ozanakturk/Dragonfly/final report/figures/leakage.jpg

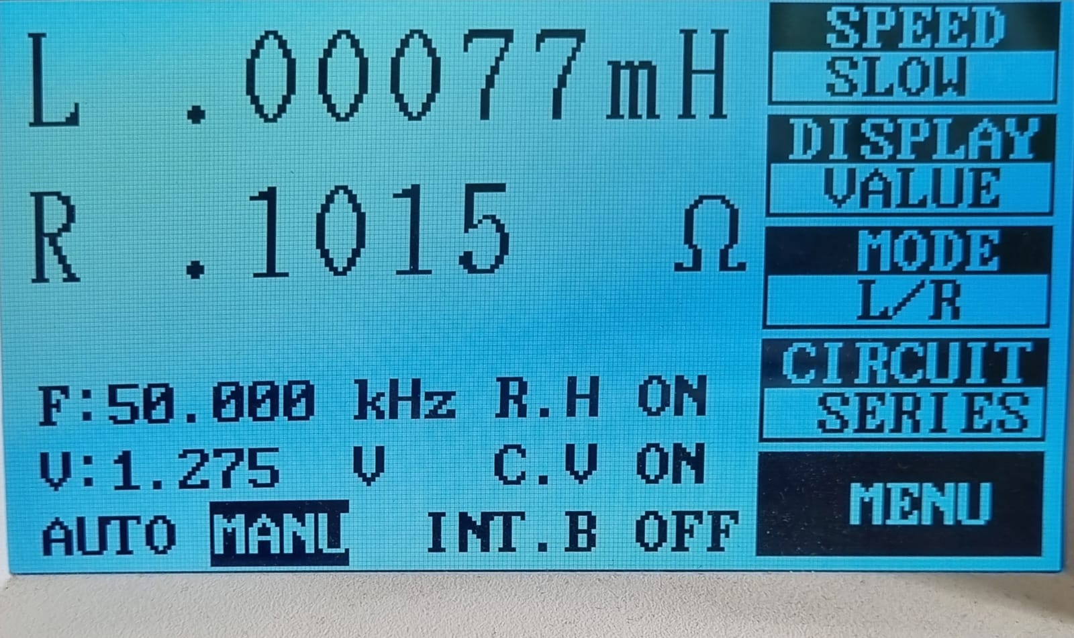
final report/figures/leakage.jpg
