ozanakturk/Dragonfly/final report/figures/trafo test.jpg

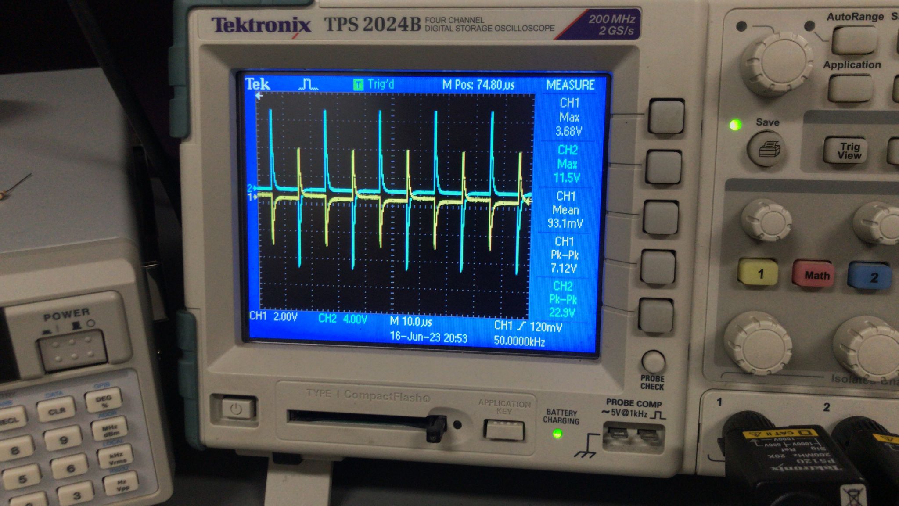
final report/figures/trafo test.jpg
