ozanakturk/Dragonfly/README.md

# DRAGONFLY - 2022/2023 EE464 Project Group
