ozanakturk/Dragonfly/presentation/EE464 Hardware Project Presentation.pptx

## EE464 Hardware Project Presentation


Group Name: Dragonfly

## Specifications

- Minimum Input Voltage: 12 V
- Maximum Input Voltage: 18 V
- Output Voltage: 48 V
- Output Power: 48 W
- Output Voltage Peak-to-Peak Ripple: 3%
- Line Regulation(Deviation of percent output voltage when input voltage is changed from its minimum to maximum or vice versa): 3%
- Load Regulation(Deviation of percent output voltage when load current is changed from 10% to 100% or vice versa): 3%

## Topology Selection: Flyback Converter

- Most common isolated converter
- Smaller number of components
- Low cost
- Less number of turn on the transformer
- Easy to control

## Theoretical Calculations

- N2/N1 = 3 & 0.47≤D≤0.58
- Lm = 59.68 uH
- Im_avg = 6.9A, Im_max = 8.3A
- Npri = 16
- MMF = 22.68 A-t
- Rpri = 107.8 / n_pri, Rsec = 323.4 / n_sec
- B_max = 0.12T, Pcore = 6.68W, Pcopper = 1.42W
- Efficiency = 85.56% (only core and copper losses are included)

## Simulation Results

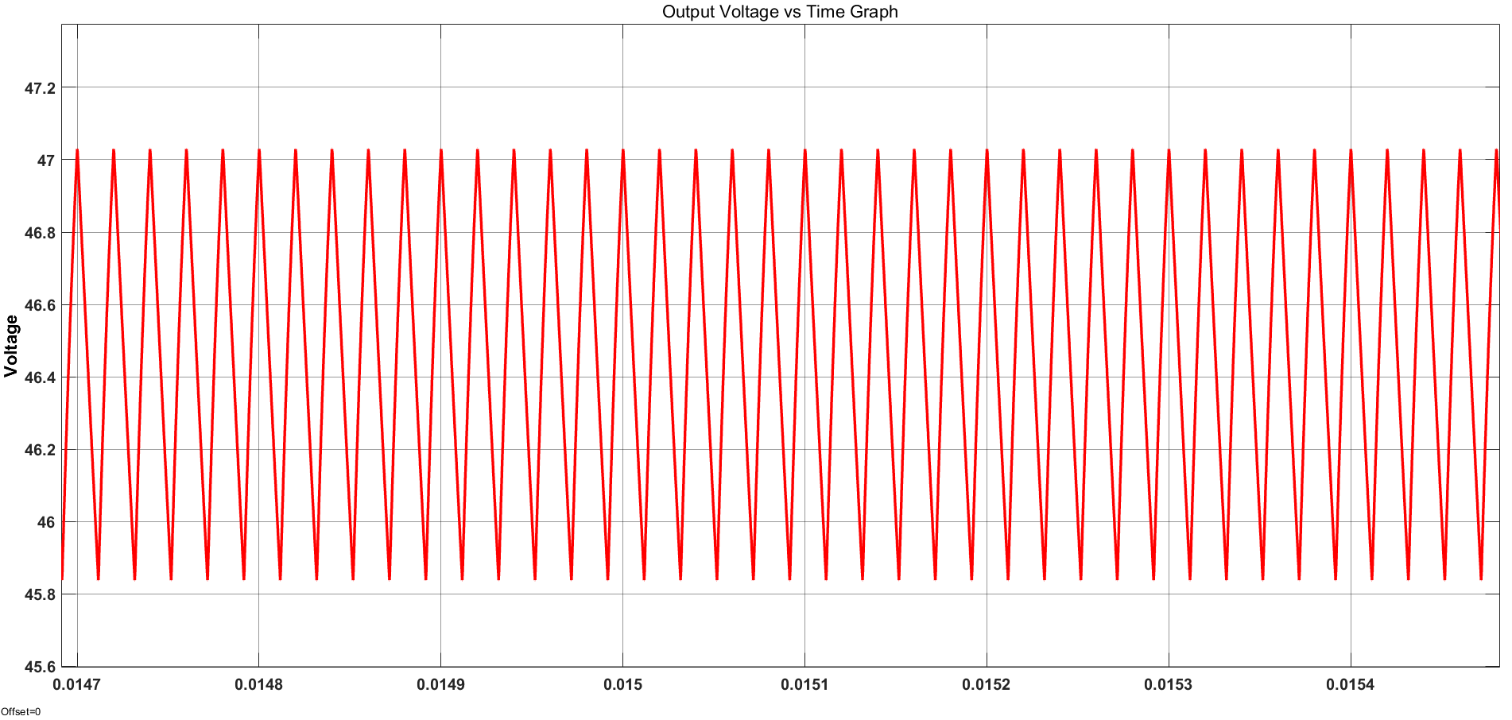
[picture p10: figure]
metin, ekran görüntüsü, çizgi, öykü gelişim çizgisi; kumpas; grafiğini çıkarma içeren bir resim Açıklama otomatik olarak oluşturuldu

(∆Vo)/(Vo)=1.19/46.46∗100=2.56%

## Slide 6

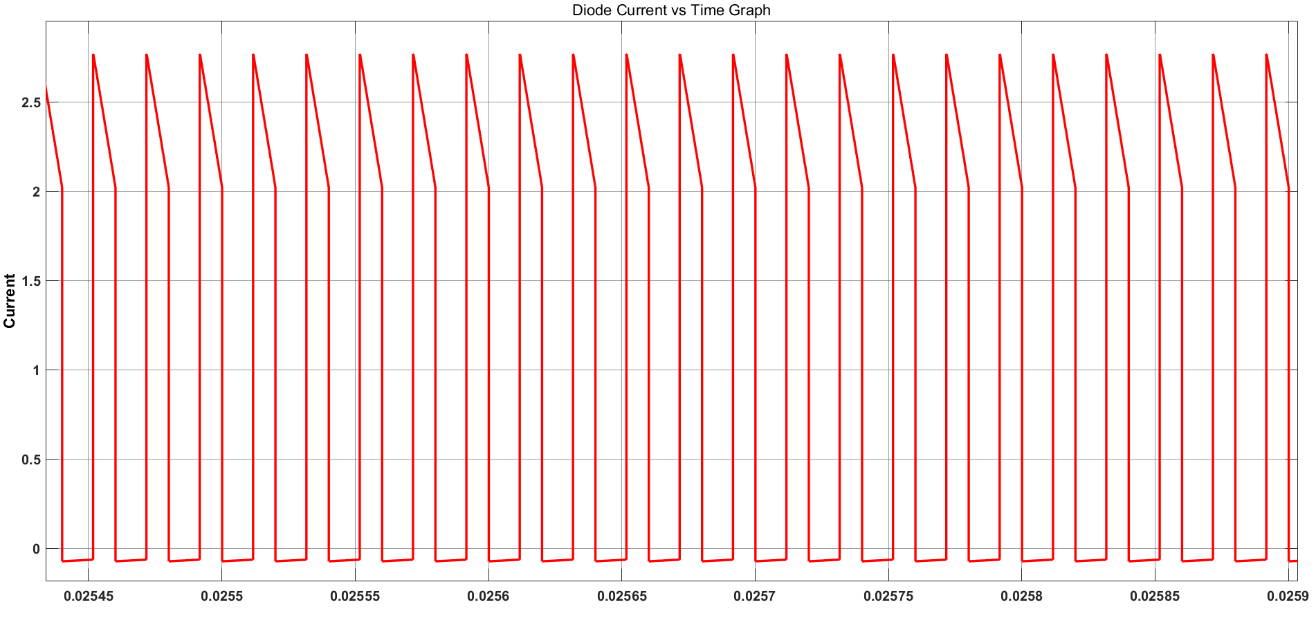
[picture p11: figure]
metin, çizgi, öykü gelişim çizgisi; kumpas; grafiğini çıkarma, ekran görüntüsü içeren bir resim Açıklama otomatik olarak oluşturuldu

Id_max = 2.77A
Pd_max = 1.07W

## Slide 7

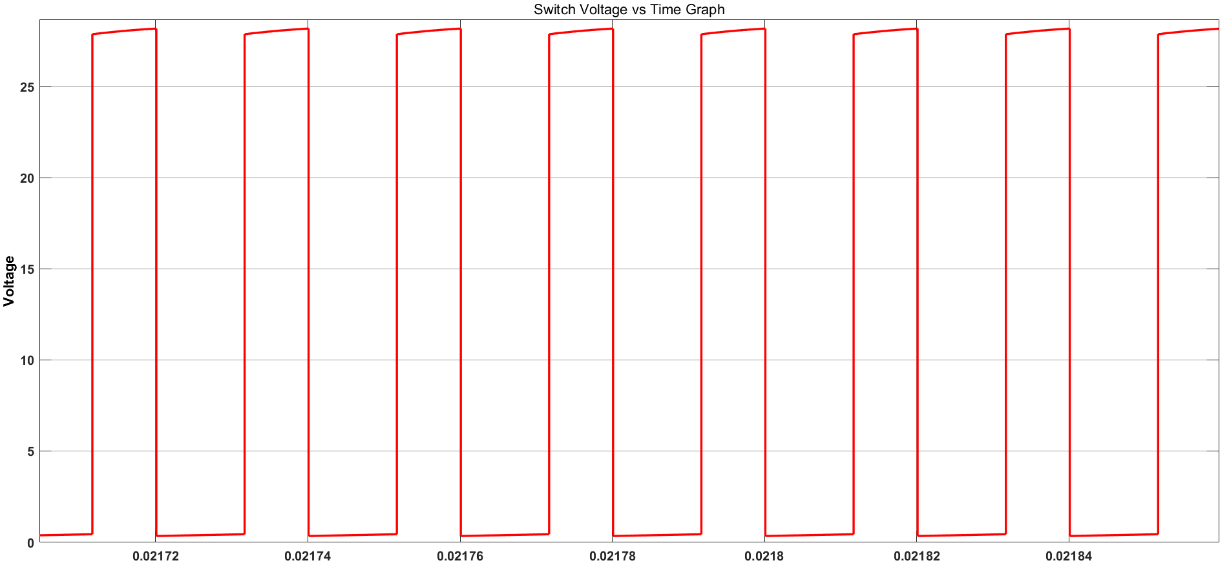
[picture p12: figure]
metin, çizgi, öykü gelişim çizgisi; kumpas; grafiğini çıkarma, diyagram içeren bir resim Açıklama otomatik olarak oluşturuldu

Vsw_max = 28.18V

## Slide 8

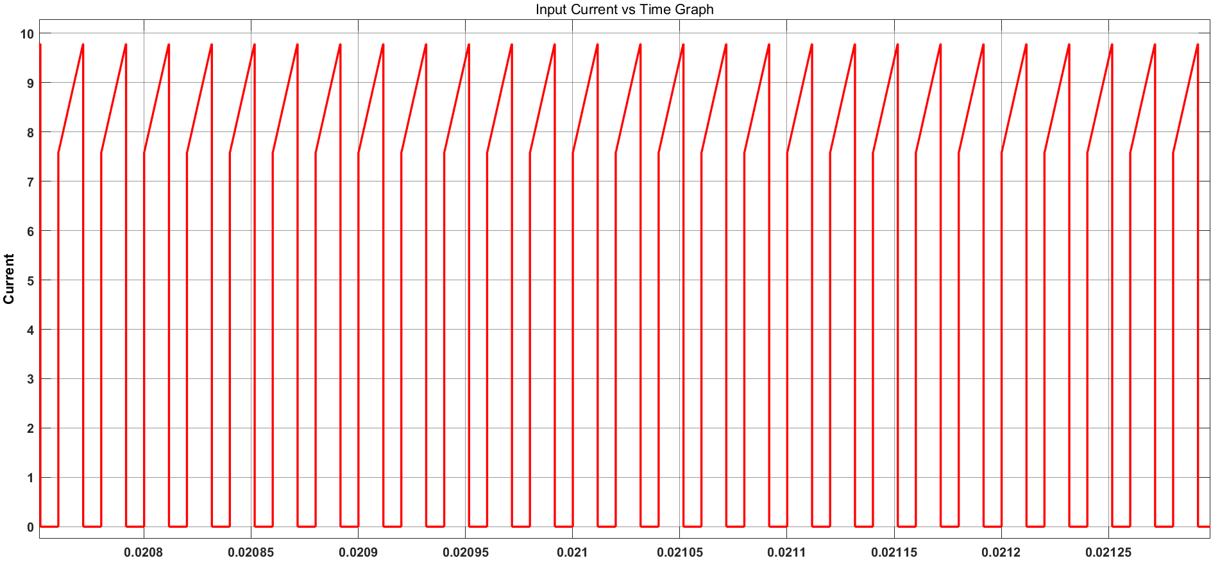
[picture p13: figure]
metin, çizgi, öykü gelişim çizgisi; kumpas; grafiğini çıkarma, paralel içeren bir resim Açıklama otomatik olarak oluşturuldu

Irms = 6.59A
Psw = 2.21W (cond: 1.92W, switching: 0.29W)

## Efficiency Calculations

Load (%) | Vin = 12V | Vin = 18V
25 | 72.2 | 65.9
50 | 77 | 76
75 | 76 | 78.6
100 | 74.4 | 79.3

## Controller: UC3843

- Typical application circuit is simpler than the alternatives

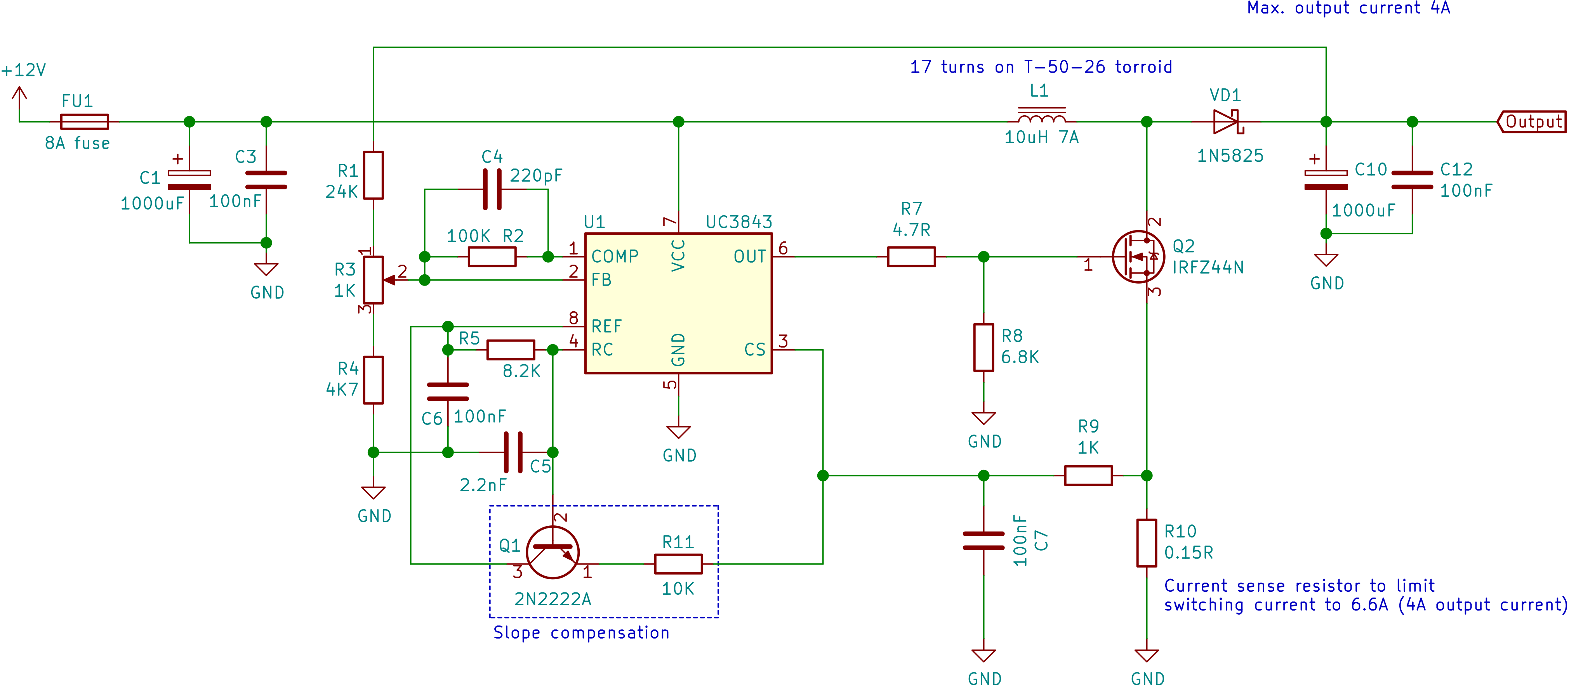
[picture p14: figure]

## Targeted Bonuses

- Analog controller
- Current-mode control
- PCB
- Industrial design
- Negative efficiency bonus (joke)

## DCM limit graph for Vin = 18V

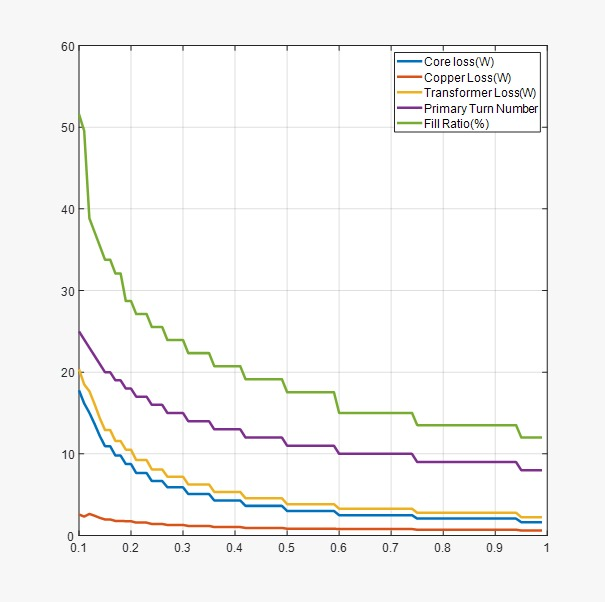
[picture p15: figure]
metin, çizgi, öykü gelişim çizgisi; kumpas; grafiğini çıkarma, diyagram içeren bir resim Açıklama otomatik olarak oluşturuldu

## Discussion

- We designed the circuit to stay in the CCM mode for 10% - 100% load. However, the core losses came out to be very high (17.79W). Then, we decreased the magnetizing inductance to stay in CCM for 25% load. The core losses decreased to 6.68W. Can we pull the DCM limit to higher load conditions to increase the efficiency?
- Can this core dissipate this much heat without any burn?
- Kool MU or ferrite + air gap?
- Is it sufficient to use Steinmetz's equation to calculate core losses?
