ozanakturk/Dragonfly/EE464_2023_HW2_Team4.docx

EE464 STATIC POWER CONVERSION II

Simulation and Magnetic Design Report

Team Members: Ozan Aktürk 2303923, Ekin Arda Çömez, Ahmet Bilgin

Deadline: 30/04/2023 23:59

Lecturer: Assoc. Prof. Ozan Keysan

Assistant: Ogün Altun

## Introduction

This report is a combination of both “HW2” and “Simulation and Magnetic Design Report”. The contents include the topology selection, magnetizing inductor calculations, core selection steps, the simulation results and loss analysis. The aim of the report is to prepare a template for the hardware project circuit and face the design problems before implementation.

## Topology Selection

The topology selection is done via comparing the topology types that we learnt during the lectures. The selected topologies to compare are as follows:

- Flyback
- Forward
- Push-pull
- Full Bridge
- Half Bridge

Table 1: A basic comparison between several isolated DC-DC converters

Topology Name | Optimal Power Demand | Efficiency | Number of Components | Voltage Stress | Cost
Flyback | Low (<500W) | High | 4 | High | Low
Half Bridge | Low (<500W) | High | 7 | High | Medium
Full Bridge | High (>1kW) | Medium | 9 | Medium | High
Push Pull | High (>1kW) | Medium | 8 | High | High
Forward | Low (<500W) | High | 7 | Medium | Low

Table 2: A more detailed analysis between the topologies

Topology Type | Advantages | Disadvantages
Flyback | Simplest and most commonly used isolated DC-DC converter | Additional snubber circuit for the leakage inductance di/dt
| Does not require a separate storage inductor | Relatively lower efficiency
Half Bridge | Higher power levels | Need to be careful with the switches not to short the input (leave dead time)
| The switching stresses are equal to the input voltage | Less suitable for high output currents
Full Bridge | Even higher power levels | Need to be careful with the switches not to short the input (leave dead time)
| Allows the power flow in both directions | Switching losses increase
Push Pull | Utilizes the core more efficiently, reaching high power levels | Switching control is a bit difficult
| Output current is regulated with the output inductor | Switching stresses are high
Forward | Can supply high output currents with less di/dt | Extra inductor at the output
| Gain equation is linear with the duty cycle | Not suitable for high output voltage

Considering the positives and the negatives, our final topology choice is the flyback converter. The most critical factor is the component number and the cost for us. The control method is also relatively easier. The flyback converter also makes same as the highest efficiency is not required and the project is a low-power project. As a disadvantage, a snubber design is required.

## Flyback Converter Design

Specifications of the project are listed as follows:

- Minimum Input Voltage: 12 V
- Maximum Input Voltage: 18 V
- Output Voltage: 48 V
- Output Power: 48 W
- Output Voltage Peak-to-Peak Ripple: 3%
- Line Regulation(Deviation of percent output voltage when input voltage is changed from its minimum to maximum or vice versa): 3%
- Load Regulation(Deviation of percent output voltage when load current is changed from 10% to 100% or vice versa): 3%

(Vo)/(Vin)=D/(1-D)*(N2)/(N1)

8/3≤D/(1-D)*(N2)/(N1)≤4

Let’s choose duty cycle range as

0.3≤D≤0.7

for safe operation After that, boundaries of turns ratio becomes,

1.15≤(N2)/(N1)≤9.33

Let’s select turns ratio = N1/N2 = 1/3. After that,

8/9≤D/(1-D)≤4/3

Then,

0.47≤D≤0.58

when N2/N1 = 3.

In order to design convenient transformer, the magnetizing inductance should be decided. Maximum, average and RMS value magnetizing current should be calculated. When the switch is on, input current is equal to magnetizing current. However, input current is equal to 0 when the switch is off.

Imavg=(Iin)/D=(Pout)/(Vin*D)

When the input voltage is equal to 12 V, duty cycle is equal to 0.58. Then,

Imavg=48/(12*0.58)=6.9 A

When the input voltage is equal to 18 V, duty cycle is equal to 0.47. After that,

Imavg=48/(18*0.47)=5.67 A

The ripple current formula is given below as;

∆Im=(Vin*D*Ts)/(Lm)

We assume that fs = 50 kHz because a lot of controllers work at that frequency. Moreover, we should consider the case of input voltage = 18 V and D = 0.47 because ripple current is larger for larger Vin*D values for same inductance value. In this case, the maximum ripple current would be equal to 5.67*2 = 11.34 A to stay at continous conduction mode. Hence,

Lm≥(18*0.47)/(11.34*50*10^3)=14.92 uH

For the case of input voltage = 12 V, D = 0.58 and ripple current = 6.9*2 = 13.8 A;

Lm≥(12*0.58)/(13.8*50*10^3)=10.08 uH

This result also verifies that Lm should be greater than 14.92 uH.

To decide the Lm current ripple we consider the 10% load case. For Vin = 18V, the minimum inductor current should not be dropping to zero. Then;

∆Im=0.1*5.67*2 = 1.134A

Imax = 6.9 + 1.134/2 = 7.467A

Then,

Lm≥(18*0.47)/(1.134*50*10^3)=149.2 uH

For the core selection, we consider magnetic flux, cross sectional area of the core and copper properties. First, we searched the ferrite cores, however, they are not suitable for flyback converter design if we do not use air gap. The reason is that they have large permeability so that they are not convenient for storing energy. Then, we look at Kool Mu cores from Magnetics from the excel table. We prepared Matlab Script that we also added it to the Github repository. We compared different cores from the Excel table that are already in the lab and will come in the May. Moreover, we have benefitted from the Magnetics Powder Core Catalog. We have specifications of;

- Minimum inductance = 149.2 uH = 0.1492 mH
- The maximum current = 7.467 A

After that, from the formula of

L*I^2 =8. 31 mH*A^2

we moved on the core selector charts. Then, the core 00K4022E090 satisfied the requirements of our project. Moreover, it is also available in the lab.

The inductance factor of the core is AL = 281 nH/T^2. However, it can be as +- 8%. Therefore, the minimum inductance factor is calculated as 258.52 nH/T^2.

We have calculated to primary number of turns as;

Npri=√((Lm)/(ALmin))= √((149.2*10^(-6))/(258.52*10^(-9)))= 24.0236

However, the number of turns should be integer number. Therefore we have taken as

N1=25

This number of turns is calculated for the no load case. To calculate the number of turns required at full load, determine the DC bias level:

H=4*π*N*I/(le)=23.84 Oe

Then, we introduced the Permeability versus DC Bias Curves for E cores. From that graph, we found that

μr %= 82%

This means, the relative permeability of the core decreases to 82% of ideal permeability of the core. Then, the resulting N can be calculated as

25/0.82=31

If we recalculate the DC Bias level with 31 turns,

H=4*π*N*I/(le)=29.56 Oe

Then, we introduced again the Permeability versus DC Bias Curves for E cores. From that graph, we found that

μr %= 75%

of initial permeability at 29.56 Oe. Then, we multiplied the effective inductance as

ALeff=258.52*75/100=193.89 (nH)/(T^2)

After that, the resulting inductance with N = 31 and 29.56 Oe is

L=N^2 *ALeff=186.33 uH

After that, we have calculated the reluctance of the core from the formula of

R=(Le)/(μ0*μr*Ae)=(98.4*10^(-3))/(4*π*10^(-7) *90*237*10^(-6))=3.6711*10^6 A/Wb

Then, from the part a, we calculated Imax as a 7.467 A. The maximum flux in the core is calculated as

ϕ=Npri*(Imax)/R=(31*7.467)/(3.6711*10^6)=6.3*10^(-5) Wb

Then, the maximum flux density in the core can be calculated as ;

B=ϕ/(Ae)=(6.3*10^(-5))/(237*10^(-6))=0.266 T

## c) A

## d) A

## e) A

Fig. 1. Figures with white background, axes names with good font.
Fig. 2. Grammarly.

## Conclusions

NOT SUMMARY

## References

Switch Mode Power Supply Topologies: A Comparison (we-online.com) (https://www.we-online.com/en/news-center/blog?d=switch-mode-power-supply)

The comparisons of DC DC converters | Download Table (researchgate.net) (https://www.researchgate.net/figure/The-comparisons-of-DC-DC-converters_tbl2_327422059)
