ozanakturk/Dragonfly/topology selection figures/dc-dc-image1.png

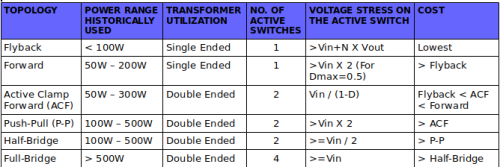
topology selection figures/dc-dc-image1.png
