ozanakturk/Dragonfly/topology selection figures/The-comparisons-of-DC-DC-converters.png

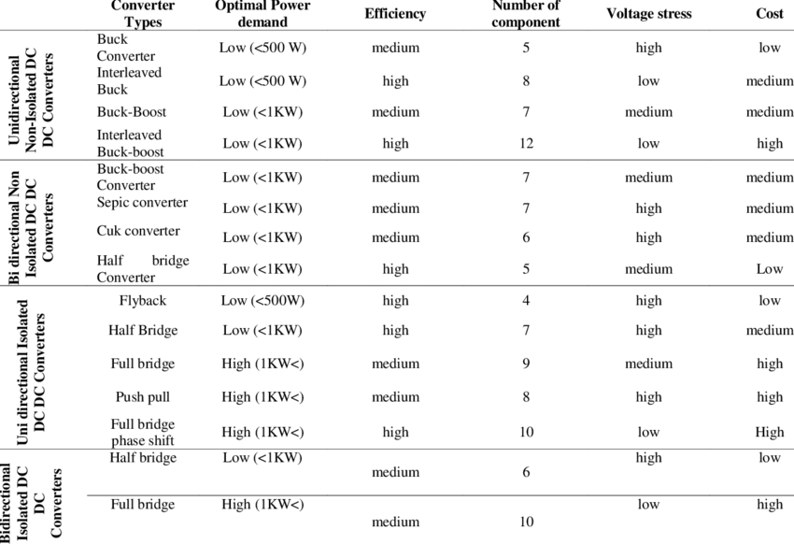
topology selection figures/The-comparisons-of-DC-DC-converters.png
