ozanakturk/Dragonfly/WBDesign3.pdf

## WEBENCH ® Design Report

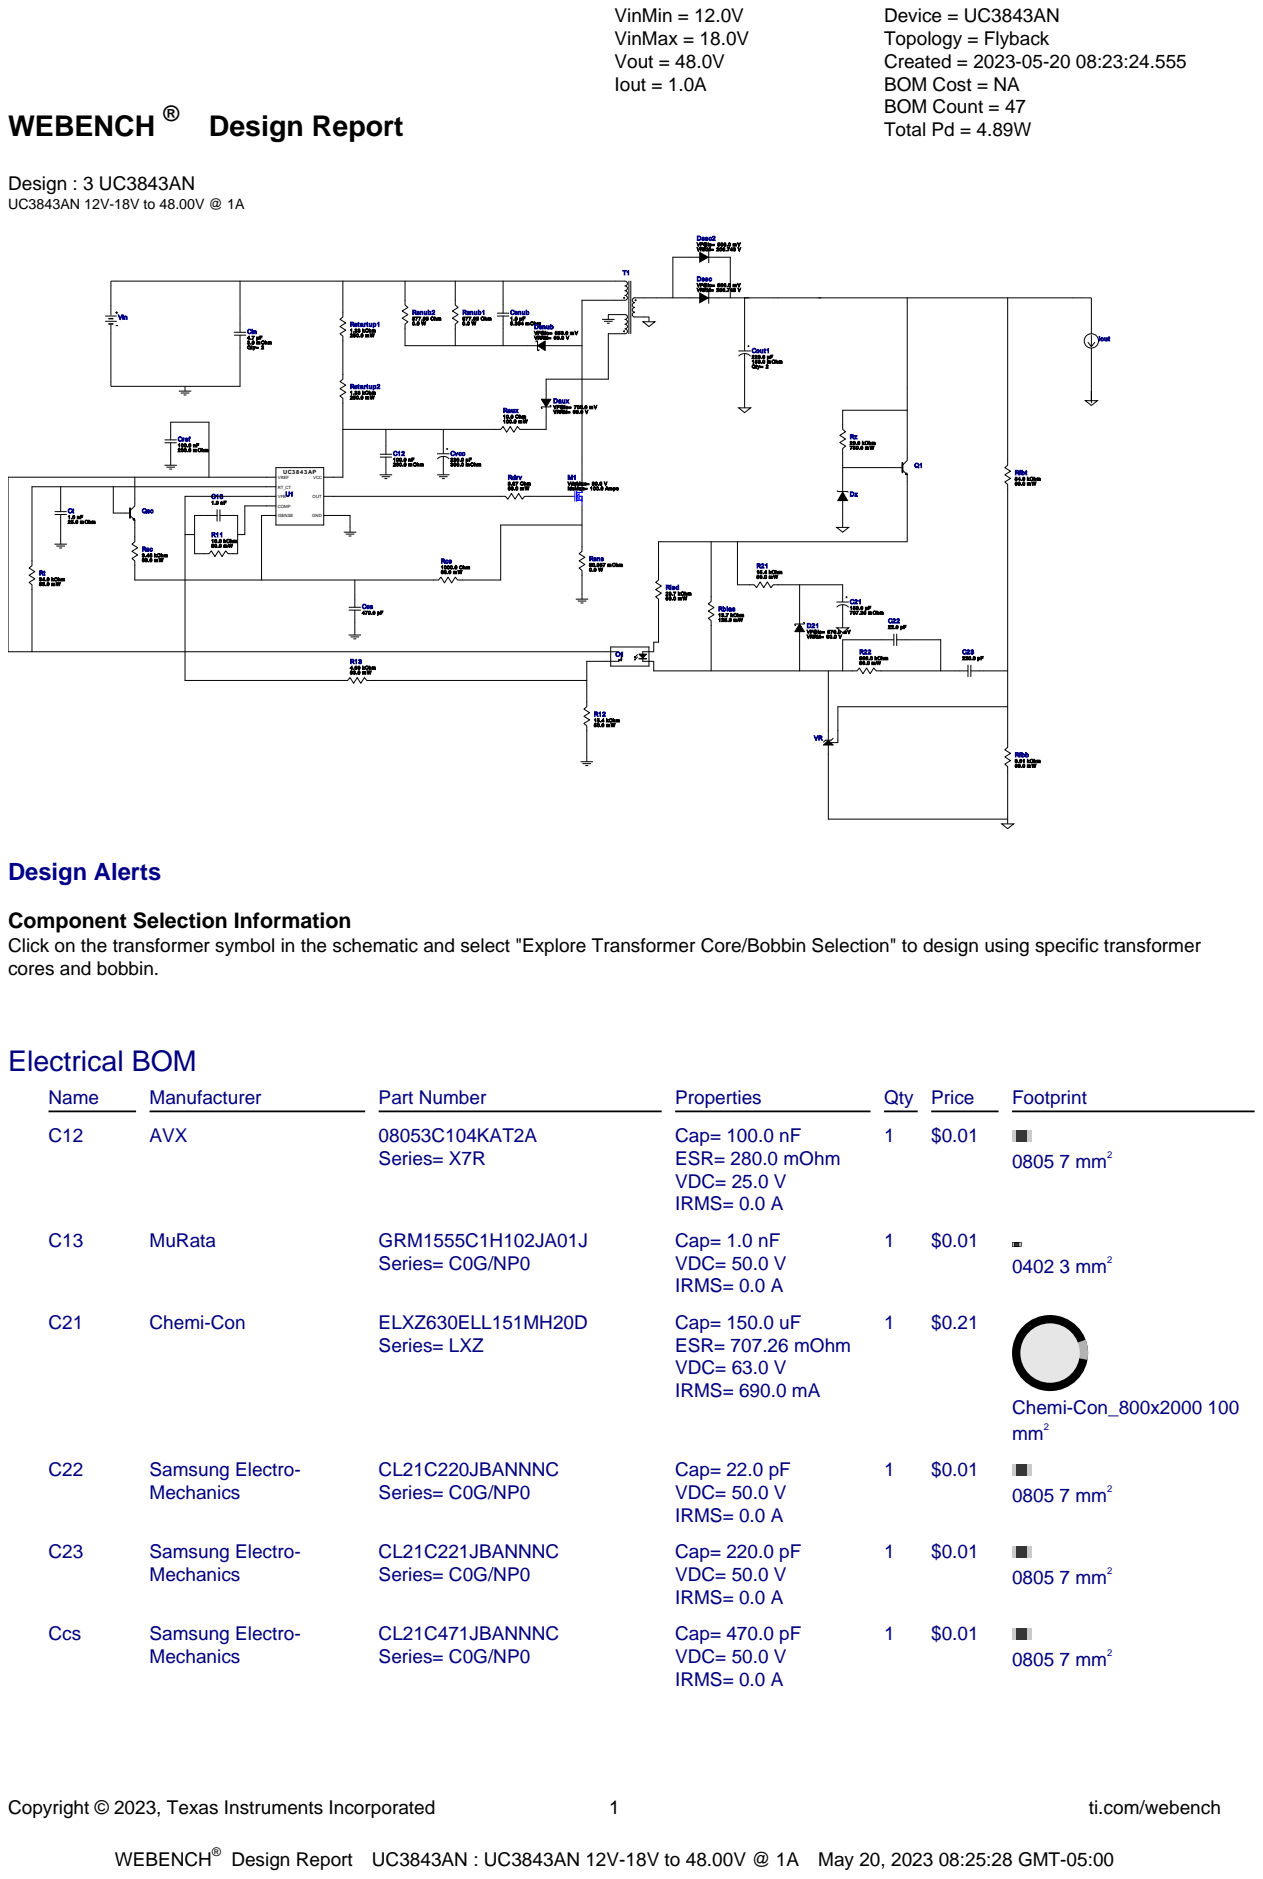
[picture p37: page 1]

Component Selection Information
Click on the transformer symbol in the schematic and select "Explore Transformer Core/Bobbin Selection" to design using specific transformer
cores and bobbin.

Design Report UC3843AN : UC3843AN 12V-18V to 48.00V @ 1A May 20, 2023 08:25:28 GMT-05:00

Design

Copyright © 2023, Texas Instruments Incorporated | 2 | ti.com/webench
Name | Manufacturer | Part Number | Properties | Qty Price | Footprint
Cin | MuRata | GRM31CR71H475KA12L (http://search.murata.co.jp/Ceramy/PnsearchViewAction.do) Series= X7R | Cap= 4.7 uF ESR= 3.0 mOhm VDC= 50.0 V IRMS= 4.98 A
2 | $0.10
| | | | | 1206 11 mm²
Cout1 | Panasonic | EEV-FK2A221M (http://www.panasonic.com/industrial/components/pdf/smt%5Faec%5F050505.pdf) Series= FK | Cap= 220.0 uF ESR= 153.0 mOhm VDC= 100.0 V IRMS= 917.0 mA
2 | $1.60

SM_RADIAL_K16 483 mm²
Cref | AVX | 08053C104KAT2A (http://datasheets.avx.com/X7RDielectric.pdf) Series= X7R

Cap= 100.0 nF
ESR= 280.0 mOhm
VDC= 25.0 V
IRMS= 0.0 A

1 $0.01
0805 7 mm²
Csnub | MuRata | GRM31CR72A105KA01L (http://psearch.en.murata.com/capacitor/result/smd/?status%3Dall%26pid%3DGRM31CR72A105KA01L) Series= X7R

Cap= 1.0 uF
ESR= 5.334 mOhm
VDC= 100.0 V
IRMS= 1.55432 A

1 $0.11
1206_190 11 mm²
Ct | Kemet | C0805C102J5GACTU (http://capacitoredge.kemet.com/capedge2/DataSheet/Datasheet%2DC0805C102J5GACTU.pdf?pn%3DC0805C102J5GACTU) Series= C0G/NP0

Cap= 1.0 nF
ESR= 25.0 mOhm
VDC= 50.0 V
IRMS= 1.71 A

1 $0.02
0805 7 mm²
Cvcc | Chemi-Con | EMVY350ADA221MHA0G (http://www.chemi%2Dcon.co.jp/cgi%2Dbin/CAT%5FDB/SEARCH/cat%5Fdb%5Fal.cgi?e%3De%26j%3Dp%26pdfname%3Dmvy) Series= MVY

Cap= 220.0 uF
ESR= 300.0 mOhm
VDC= 35.0 V
IRMS= 450.0 mA

1 $0.28

CAPSMT_62_HA0 106 mm²
D21 | Nexperia | PMEG6010CEH,115 (http://www.nxp.com/documents/data%5Fsheet/PMEG6010CEH%5FPMEG6010CEJ.pdf) | VF@Io= 570.0 mV VRRM= 60.0 V | 1 | $0.04
SOD-123F 12 mm²
Daux | Fairchild Semiconductor SS26FL | VF@Io= 700.0 mV
| | | VRRM= 60.0 V | 1 | $0.11
SOD-123F 12 mm²
Dsec | CUSTOM | CUSTOM | VF@Io= 500.0 mV VRRM= 206.743 V | 1 | NA
CUSTOM 0 mm²
Dsec2 | CUSTOM | CUSTOM | VF@Io= 500.0 mV VRRM= 206.743 V | 1 | NA
CUSTOM 0 mm²
Dsnub | Fairchild Semiconductor FSV360FP | VF@Io= 650.0 mV
| | | VRRM= 60.0 V | 1 | $0.13
SOD-123HE 13 mm²
Dz | Diodes Inc. | MMSZ5250B-7-F (http://www.diodes.com/datasheets/ds18010.pdf) | Zener | 1 | $0.04
SOD-123 13 mm²
M1 | Texas Instruments | CSD19502Q5B (http://www.ti.com/lit/ds/symlink/csd19502q5b.pdf) | VdsMax= 80.0 V IdsMax= 100.0 Amps | 1 | $0.81
DQK0006C 9 mm²
O1 | Vishay-Semiconductor | TCMT1107 | Optocoupler | 1 | $0.19
SOP-4 44 mm²
Q1 | ON Semiconductor | BC846BLT1G (http://www.onsemi.com/pub%5Flink/Collateral/BC846ALT1%2DD.PDF) | Bipolar Transistor | 1 | $0.03

SOT-23 14 mm²
Qsc | STMicroelectronics | 2N2222A (http://www.st.com/web/en/resource/technical/document/datasheet/CD00003223.pdf) | Bipolar Transistor | 1 | $1.19

TO-18 57 mm²
R11 | Yageo | RC0201FR-0710KL (http://www.yageo.com/exep/pages/download/literatures/PYu%2DR%5FMarking%5F2.pdf) Series= ? | Res= 10.0 kOhm Power= 50.0 mW Tolerance= 1.0% | 1 | $0.01
0201 2 mm²
R12 | Yageo | RC0201FR-0715K4L (http://www.yageo.com/exep/pages/download/literatures/PYu%2DR%5FMarking%5F2.pdf) Series= ? | Res= 15.4 kOhm Power= 50.0 mW Tolerance= 1.0% | 1 | $0.01
0201 2 mm²

Copyright © 2023, Texas Instruments Incorporated | 3 | ti.com/webench
Name | Manufacturer | Part Number | Properties | Qty Price | Footprint
R13 | Vishay-Dale | CRCW04024K99FKED (http://www.vishay.com/docs/20035/dcrcwe3.pdf) Series= CRCW..e3 | Res= 4.99 kOhm Power= 63.0 mW Tolerance= 1.0%
1 | $0.01
| | | | | 0402 3 mm²
R21 | Yageo | RC0201FR-0715K4L (http://www.yageo.com/exep/pages/download/literatures/PYu%2DR%5FMarking%5F2.pdf) Series= ? | Res= 15.4 kOhm Power= 50.0 mW Tolerance= 1.0%
1 | $0.01
| | | | | 0201 2 mm²
R22 | Yageo | RC0201FR-7D866KL (http://www.yageo.com/documents/recent/PYu%2DRC%5FGroup%5F51%5FRoHS%5FL%5F5.pdf) Series= ? | Res= 866.0 kOhm Power= 50.0 mW Tolerance= 1.0%
1 | $0.01
| | | | | 0201 2 mm²
Raux | Vishay-Dale | CRCW060310R0FKEA (http://www.vishay.com/docs/20035/dcrcwe3.pdf) Series= CRCW..e3 | Res= 10.0 Ohm Power= 100.0 mW Tolerance= 1.0%
1 | $0.01
| | | | | 0603 5 mm²
Rbias | Vishay-Dale | CRCW080513K7FKEA (http://www.vishay.com/docs/20035/dcrcwe3.pdf) Series= CRCW..e3 | Res= 13.7 kOhm Power= 125.0 mW Tolerance= 1.0%
1 | $0.01
| | | | | 0805 7 mm²
Rcs | Vishay-Dale | CRCW04021K00FKED (http://www.vishay.com/docs/20035/dcrcwe3.pdf) Series= CRCW..e3 | Res= 1000.0 Ohm Power= 63.0 mW Tolerance= 1.0%
1 | $0.01
| | | | | 0402 3 mm²
Rdrv | Vishay-Dale | CRCW04028R87FKED (http://www.vishay.com/docs/20035/dcrcwe3.pdf) Series= CRCW..e3 | Res= 8.87 Ohm Power= 63.0 mW Tolerance= 1.0%
1 | $0.01
| | | | | 0402 3 mm²
Rfbb | Vishay-Dale | CRCW04023K01FKED (http://www.vishay.com/docs/20035/dcrcwe3.pdf) Series= CRCW..e3 | Res= 3.01 kOhm Power= 63.0 mW Tolerance= 1.0%
1 | $0.01
| | | | | 0402 3 mm²
Rfbt | Vishay-Dale | CRCW040254K9FKED (http://www.vishay.com/docs/20035/dcrcwe3.pdf) Series= CRCW..e3 | Res= 54.9 kOhm Power= 63.0 mW Tolerance= 1.0%
1 | $0.01
| | | | | 0402 3 mm²
Rled | Yageo | RC0201FR-0723K7L (http://www.yageo.com/exep/pages/download/literatures/PYu%2DR%5FMarking%5F2.pdf) Series= ? | Res= 23.7 kOhm Power= 50.0 mW Tolerance= 1.0%
1 | $0.01
| | | | | 0201 2 mm²
Rsc | Vishay-Dale | CRCW04023K48FKED (http://www.vishay.com/docs/20035/dcrcwe3.pdf) Series= CRCW..e3 | Res= 3.48 kOhm Power= 63.0 mW Tolerance= 1.0%
1 | $0.01
| | | | | 0402 3 mm²
Rsns | CUSTOM | CUSTOM Series= ? | Res= 50.957 mOhm Power= 0.0 W Tolerance= 0.0%
1 | NA
| | | | | CUSTOM 0 mm²
Rsnub1 | CUSTOM | CUSTOM Series= ? | Res= 577.65 Ohm Power= 0.0 W Tolerance= 0.0%
1 | NA
| | | | | CUSTOM 0 mm²
Rsnub2 | CUSTOM | CUSTOM Series= ? | Res= 577.65 Ohm Power= 0.0 W Tolerance= 0.0%
1 | NA
| | | | | CUSTOM 0 mm²
Rstartup1 Vishay-Dale | CRCW12061K33FKEA (http://www.vishay.com/docs/20035/dcrcwe3.pdf)
| | Series= CRCW..e3 | Res= 1.33 kOhm Power= 250.0 mW Tolerance= 1.0%
1 | $0.01
| | | | | 1206 11 mm²
Rstartup2 Vishay-Dale | CRCW12061K33FKEA (http://www.vishay.com/docs/20035/dcrcwe3.pdf)
| | Series= CRCW..e3 | Res= 1.33 kOhm Power= 250.0 mW Tolerance= 1.0%
1 | $0.01
| | | | | 1206 11 mm²
Rt | Vishay-Dale | CRCW040234K0FKED (http://www.vishay.com/docs/20035/dcrcwe3.pdf) Series= CRCW..e3 | Res= 34.0 kOhm Power= 63.0 mW Tolerance= 1.0%
1 | $0.01
| | | | | 0402 3 mm²
Rz | Vishay-Dale | CRCW201020K0FKEF (http://www.vishay.com/docs/20035/dcrcwe3.pdf) Series= CRCW..e3 | Res= 20.0 kOhm Power= 750.0 mW Tolerance= 1.0%
1 | $0.04
| | | | | 2010 32 mm²
T1 | Core=Wurth Elektronik , CoilFormer=Wurth Elektronik | Core=150-0693 , CoilFormer=070-6362 (http://katalog.we-online.de/pcd/datasheet/070-6362.pdf) | Lp= 13.0 µH Turns Ratio(Nas)= 6:22 Turns Ratio(Nps)= 7:22 Npri= 7.0 Naux= 6.0 Nsec= 22.0
1 | NA
| | | | | PQ2620 1009 mm²

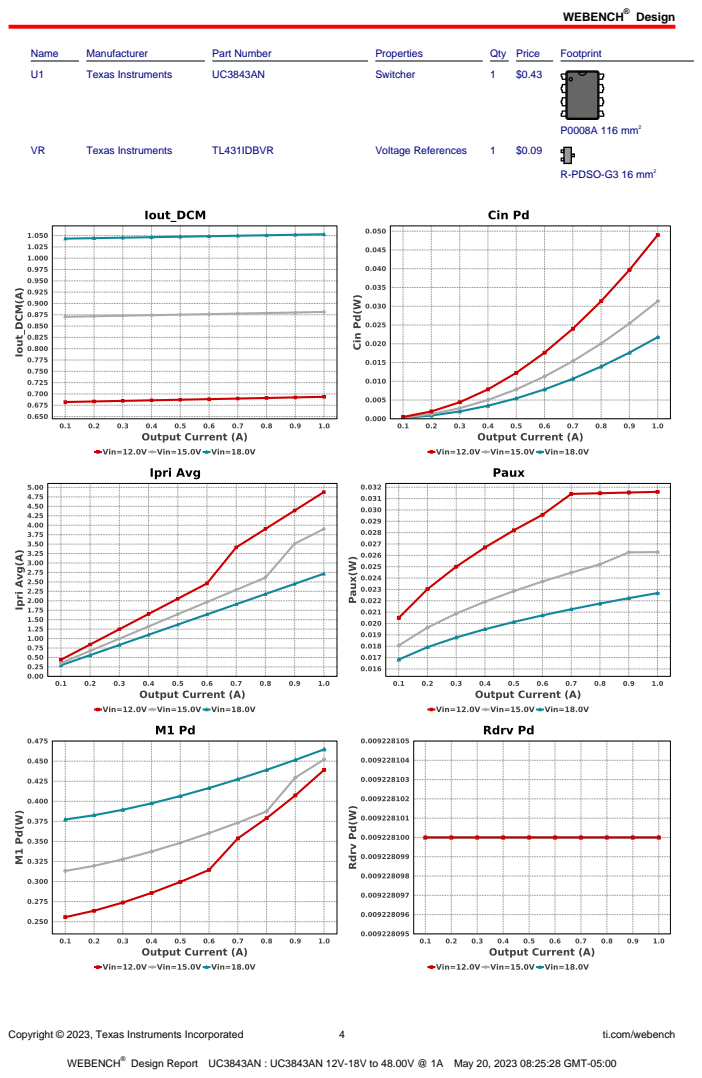
[picture p38: page 4]
Copyright © 2023, Texas Instruments Incorporated; ti.com/webench; Name; Manufacturer; Part Number; Properties; Qty Price; Footprint; Texas Instruments; Switcher; P0008A 116 mm²; TL431IDBVR; Voltage References; R-PDSO-G3 16 mm²

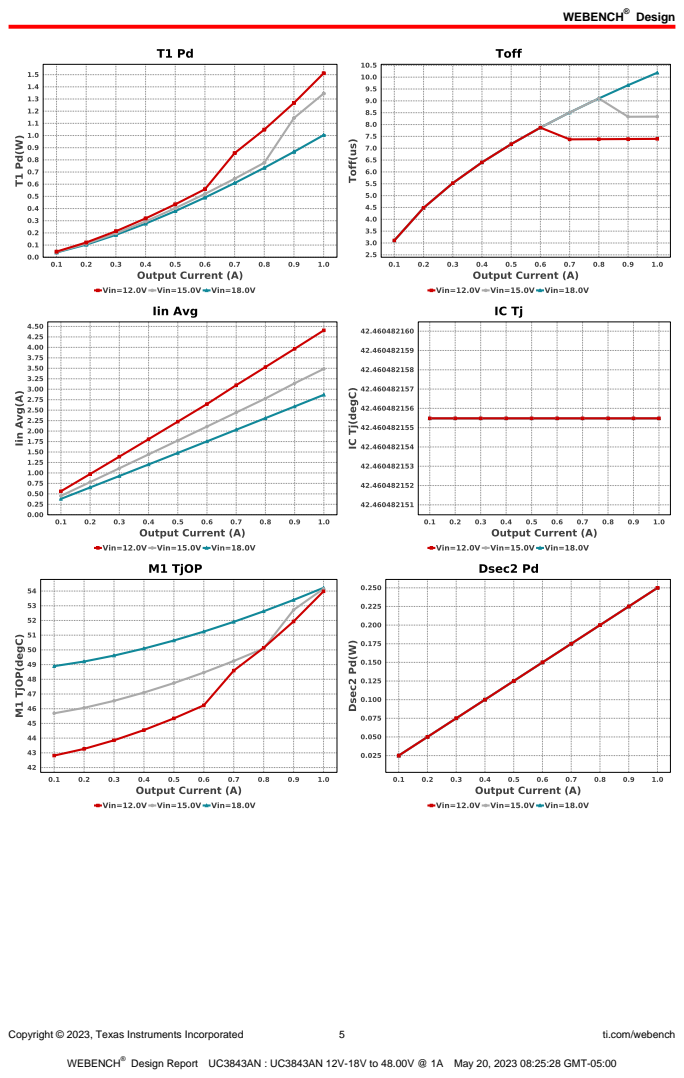
[picture p39: page 5]
Copyright © 2023, Texas Instruments Incorporated; ti.com/webench

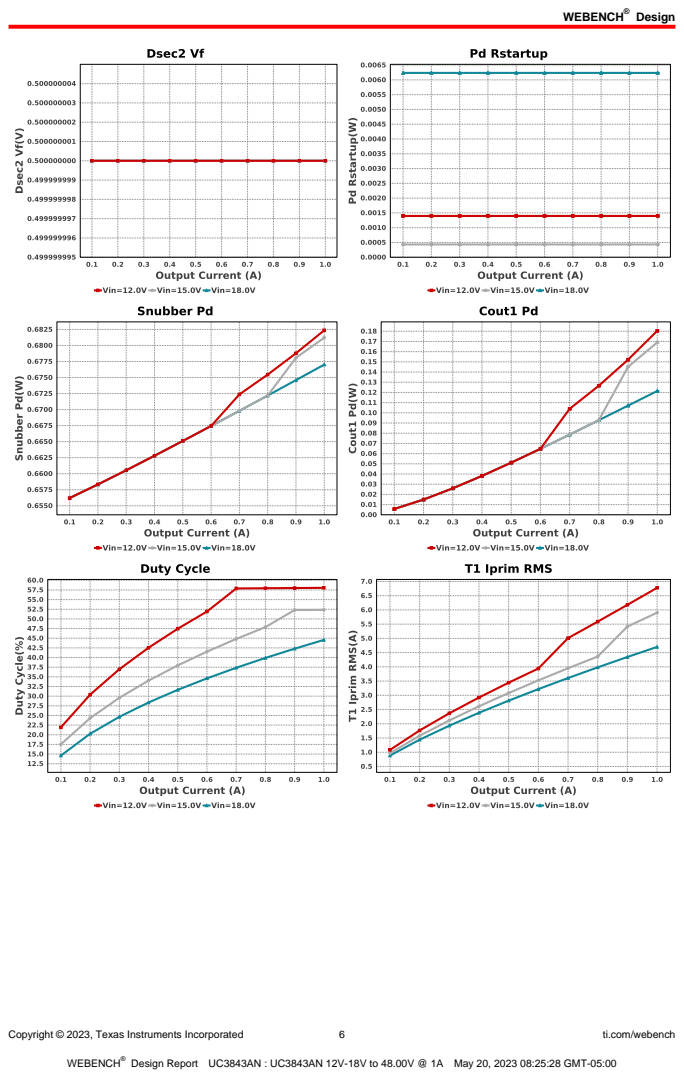
[picture p40: page 6]
Copyright © 2023, Texas Instruments Incorporated; ti.com/webench

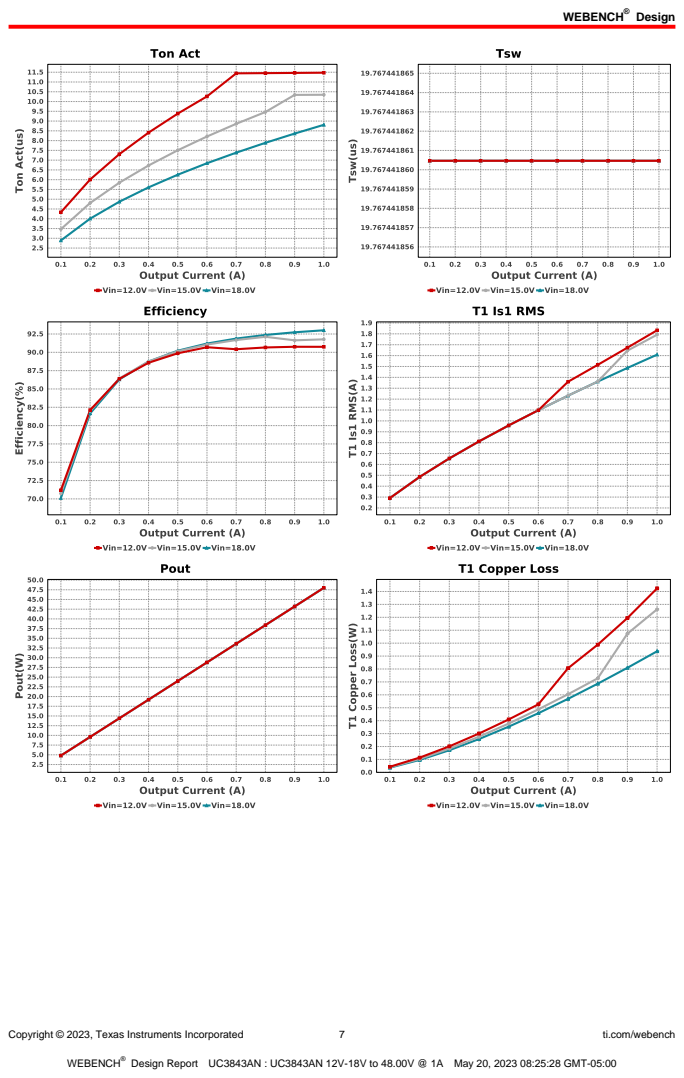
[picture p41: page 7]
Copyright © 2023, Texas Instruments Incorporated; ti.com/webench

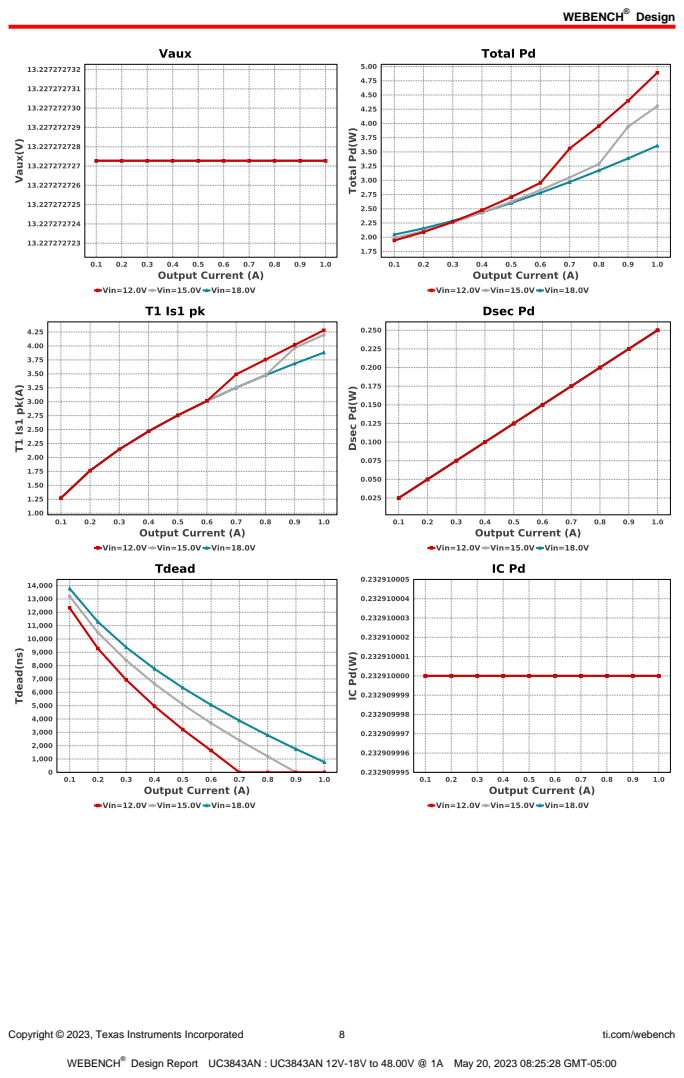
[picture p42: page 8]
Copyright © 2023, Texas Instruments Incorporated; ti.com/webench

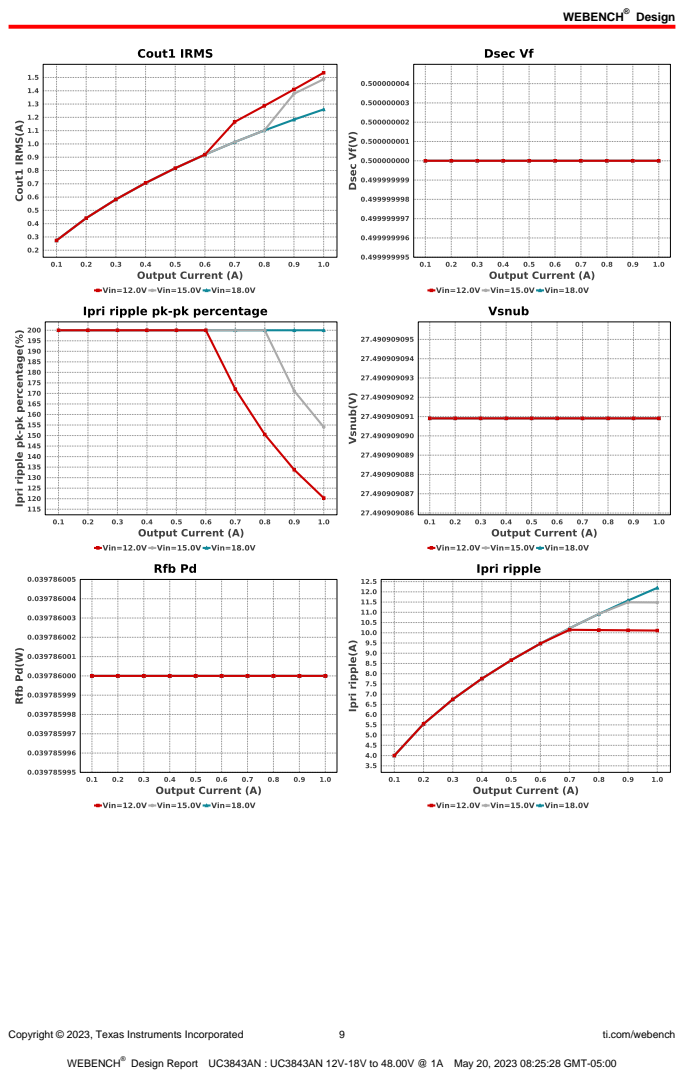
[picture p43: page 9]
Copyright © 2023, Texas Instruments Incorporated; ti.com/webench

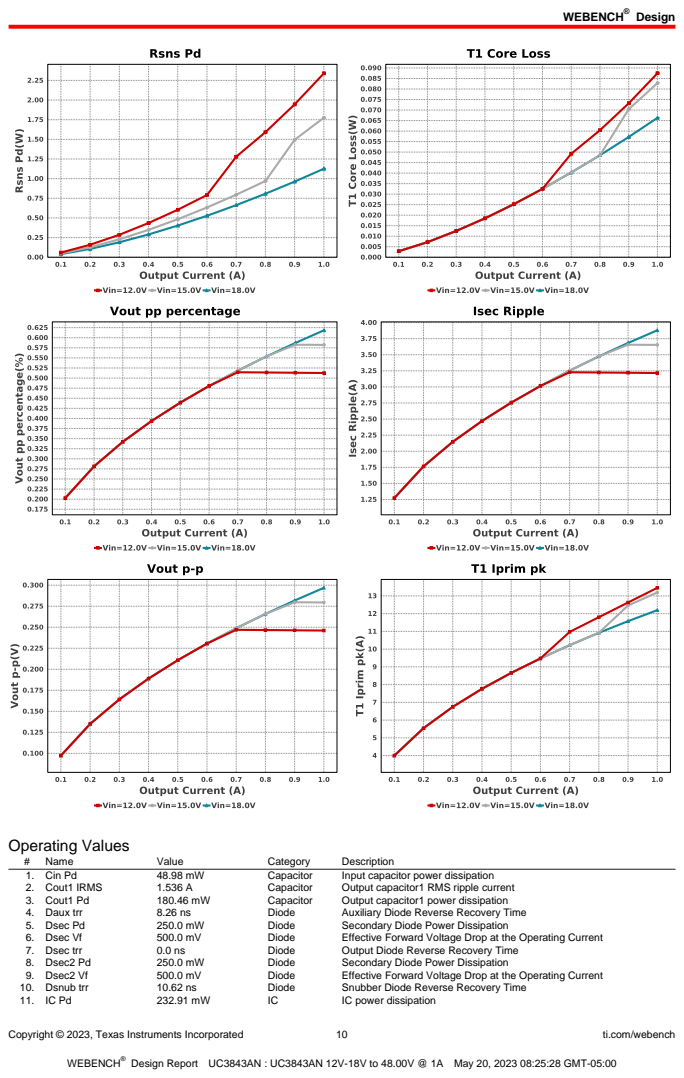
[picture p44: page 10]
Copyright © 2023, Texas Instruments Incorporated; ti.com/webench; Operating Values; Name; Value; Category; Description; 1. Cin Pd; Capacitor; Input capacitor power dissipation; 2. Cout1 IRMS; Output capacitor1 RMS ripple current; 3. Cout1 Pd; Output capacitor1 power dissipation; 4. Daux trr; Diode; Auxiliary Diode Reverse Recovery Time; 5. Dsec Pd; Secondary Diode Power Dissipation; 6. Dsec Vf; Effective Forward Voltage Drop at the Operating Current; 7. Dsec trr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

Copyright © 2023, Texas Instruments Incorporated | 11 | ti.com/webench
# | Name | Value | Category | Description

12. IC Tj | 42.46 degC | IC | IC junction temperature
13. ICThetaJA | 53.5 degC/W | IC | IC junction-to-ambient thermal resistance
14. Iin Avg | 4.408 A | IC | Average input current
15. M1 Pd | 439.08 mW | Mosfet | M1 MOSFET total power dissipation
16. M1 TjOP | 53.983 degC | Mosfet | M1 MOSFET junction temperature
17. Cin Pd | 48.98 mW | Power | Input capacitor power dissipation
18. Cout1 Pd | 180.46 mW | Power | Output capacitor1 power dissipation
19. Dsec Pd | 250.0 mW | Power | Secondary Diode Power Dissipation
20. Dsec2 Pd | 250.0 mW | Power | Secondary Diode Power Dissipation
21. IC Pd | 232.91 mW | Power | IC power dissipation
22. M1 Pd | 439.08 mW | Power | M1 MOSFET total power dissipation
23. Paux | 31.594 mW | Power | Power Dissipation in Raux and Daux
24. Pd Rstartup | 1.396 mW | Power | Power Dissipation in Rstartup1 and Rstartup2
25. Rdrv Pd | 9.228 mW | Power | Power Dissipation in Gate Drive Resistor
26. Rfb Pd | 39.786 mW | Power | Rfb Power Dissipation
27. Rsns Pd | 2.34 W | Power | Current Limit Sense Resistor Power Dissipation
28. Snubber Pd | 682.371 mW | Power | Snubber Power Dissipation
29. T1 Copper Loss | 1.342 W | Power | Transformer Copper Loss Power Dissipation
30. T1 Core Loss | 80.9 mW | Power | Transformer Core Loss Power Dissipation
31. T1 Pd | 1.423 W | Power | Estimated Losses in Transformer
32. Total Pd | 4.892 W | Power | Total Power Dissipation
33. Pd Rstartup | 1.396 mW | Resistor | Power Dissipation in Rstartup1 and Rstartup2
34. Rdrv Pd | 9.228 mW | Resistor | Power Dissipation in Gate Drive Resistor
35. Rfb Pd | 39.786 mW | Resistor | Rfb Power Dissipation
36. Rsns Pd | 2.34 W | Resistor | Current Limit Sense Resistor Power Dissipation
37. BOM Count | 47 | System
| | | Information | Total Design BOM count
38. Duty Cycle | 58.051 % | System
| | | Information | Duty cycle
39. Efficiency | 90.751 % | System
| | | Information | Steady state efficiency
40. FootPrint | 2.684 k mm² | System
| | | Information | Total Foot Print Area of BOM components
41. Frequency | 50.588 kHz | System
| | | Information | Switching frequency
42. Iout | 1.0 A | System
| | | Information | Iout operating point
43. Iout_DCM | 693.684 mA | System
| | | Information | Approximate Current below which DCM mode of operation will begin
44. Mode | CCM | System
| | | Information | Conduction Mode
45. Pout | 48.0 W | System
| | | Information | Total output power
46. Tdead | 0.0 ns | System
| | | Information | Approximate Dead Time of the Regulator
47. Toff | 7.395 us | System
| | | Information | Approximate Converter Off Time
48. Ton Act | 11.475 us | System
| | | Information | Approximate Converter On Time
49. Total BOM | NA | System
| | | Information | Total BOM Cost
50. Tsw | 19.767 us | System
| | | Information | Switching Time Period
51. Vin | 12.0 V | System
| | | Information | Vin operating point
52. Vout | 48.0 V | System
| | | Information | Operational Output Voltage
53. Vout Actual | 48.002 V | System
| | | Information | Vout Actual calculated based on selected voltage divider resistors
54. Vout Tolerance | 2.242 % | System
| | | Information | Vout Tolerance based on IC Tolerance (no load) and voltage divider resistors if applicable
55. Vout p-p | 246.045 mV | System
| | | Information | Peak-to-peak output ripple voltage
56. Vout pp percentage | 512.593 m% | System
| | | Information | Output Voltage ripple percentage
57. Vsnub | 27.491 V | System
| | | Information | Voltage Across the Snubber
58. Ipri Avg | 4.877 A | Transformer | Average Current in Primary Winding over the complete Switching
| | | | Period
59. Ipri ripple | 10.108 A | Transformer | Ripple Current in the Primary Winding
60. Ipri ripple pk-pk
| percentage | 120.323 % | Transformer | Primary Current pk-pk ripple percentage(of Ipri avg during ton only)
61. Isec Ripple | 3.216 A | Transformer | Ripple Current in the Secondary Winding
62. Paux | 31.594 mW | Transformer | Power Dissipation in Raux and Daux
63. T1 Copper Loss | 1.342 W | Transformer | Transformer Copper Loss Power Dissipation
64. T1 Core Loss | 80.9 mW | Transformer | Transformer Core Loss Power Dissipation

Copyright © 2023, Texas Instruments Incorporated | 12 | ti.com/webench
# | Name | Value | Category | Description

65. T1 Iprim RMS | 6.776 A | Transformer | Transformer Primary RMS Current
66. T1 Iprim pk | 13.455 A | Transformer | Transformer Primary Peak Current
67. T1 Is1 RMS | 1.833 A | Transformer | Transformer Secondary1 RMS Current
68. T1 Is1 pk | 4.281 A | Transformer | Transformer Secondary1 Peak Current
69. T1 Pd | 1.423 W | Transformer | Estimated Losses in Transformer
70. Vaux | 13.227 V | Transformer | Auxiliary Voltage

## Design Inputs

Name | Value | Description
Iout | 1.0 | Maximum Output Current
VinMax | 18.0 | Maximum input voltage
VinMin | 12.0 | Minimum input voltage
Vout | 48.0 | Output Voltage
| base_pn | | UC3843A | Base Product Number
source | DC | Input Source Type
Ta | 30.0 | Ambient temperature
UserFsw | 50.0 k | Customer Selected Frequency


Copyright © 2023, Texas Instruments Incorporated | 13 | ti.com/webench

## Assembly

## Component Testing

Some published data on components in datasheets such as Capacitor ESR and Inductor DC resistance is based on conservative values that will guarantee that the components always exceed the specification. For design purposes it is usually better to work with typical values. Since this data is not always available it is a good practice to measure the Capacitance and ESR values of Cin and Cout, and the inductance and DC resistance of L1 before assembly of the board. Any large discrepancies in values should be electrically simulated in WEBENCH to check for instabilities and thermally simulated in WebTHERM to make sure critical temperatures are not exceeded.

## Soldering Component to Board

If board assembly is done in house it is best to tack down one terminal of a component on the board then solder the other terminal. For surface mount parts with large tabs, such as the DPAK, the tab on the back of the package should be pre-tinned with solder, then tacked into place by one of the pins. To solder the tab town to the board place the iron down on the board while resting against the tab, heating both surfaces simultaneously. Apply light pressure to the top of the plastic case until the solder flows around the part and the part is flush with the PCB. If the solder is not flowing around the board you may need a higher wattage iron (generally 25W to 30W is enough).

## Initial Startup of Circuit

It is best to initially power up the board by setting the input supply voltage to the lowest operating input voltage 12.0V and set the input supply's current limit to zero. With the input supply off connect up the input supply to Vin and GND. Connect a digital volt meter and a load if needed to set the minimum Iout of the design from Vout and GND. Turn on the input supply and slowly turn up the current limit on the input supply.
If the voltage starts to rise on the input supply continue increasing the input supply current limit while watching the output voltage. If the current increases on the input supply, but the voltage remains near zero, then there may be a short or a component misplaced on the board. Power down the board and visually inspect for solder bridges and recheck the diode and capacitor polarities. Once the power supply circuit is operational then more extensive testing may include full load testing, transient load and line tests to compare with simulation results.

## Load Testing

The setup is the same as the initial startup, except that an additional digital voltmeter is connected between Vin and GND, a load is connected between Vout and GND and a current meter is connected in series between Vout and the load. The load must be able to handle at least rated output power + 50% ( 7.5 watts for this design). Ideally the load is supplied in the form of a variable load test unit. It can also be done in the form of suitably large power resistors. When using an oscilloscope to measure waveforms on the prototype board, the ground leads of the oscilloscope probes should be as short as possible and the area of the loop formed by the ground lead should be kept to a minimum. This will help reduce ground lead inductance and eliminate EMI noise that is not actually present in the circuit.

Copyright © 2023, Texas Instruments Incorporated | 14 | ti.com/webench

## Transformer Report

# Name | Value

1. Core Part Number | 150-0693
2. Core Manufacturer | Wurth Elektronik
3. Coil Former Part Number | 070-6362
4. Coil Former Manufacturer | Wurth Elektronik

## Transformer Electrical Diagram Primary

Turns | 7.0
AWG | 24.0
Layers | 2.0
Strands | 4.0
Insulation Type | Heavy
Insulated
Magnet Wire

## Auxiliary

Turns | 6.0
AWG | 28.0
Layers | 1.0
Strands | 4.0
Insulation Type | Heavy
Insulated
Magnet Wire

## Secondary

Turns | 22.0
AWG | 26.0
Layers | 2.0
Strands | 1.0
Insulation Type | Triple Insulated

## Transformer Construction Diagram

## Winding Instruction

Winding | AWG | Turns | Winding Orientation
Primary First 1/2.0 | 24.0 | 4 | Clockwise
Auxiliary | 28.0 | 6.0 | Counter Clockwise
Triple Insulated Secondary | 26.0 | 22.0 | Counter Clockwise
Primary Second 1/2.0 | 24.0 | 3 | Clockwise

## Transformer Parameters

# Name | Value

1. Lpri | 1.3E-5H
2. Inductance Factor(Al) | 256.0nH
3. Npri | 7.0
4. Nsec | 22.0
5. Naux | 6.0
6. Core Type | PQ2620
7. Core Material | TP4A

Copyright © 2023, Texas Instruments Incorporated | 15 | ti.com/webench
# Name | Value

8. Bmax | 0.20T
9. Switching Frequency | 50.59kHz
10. DMax | 0.6
11. Ipk(Primary) | 13.6A
12. Irms(Primary) | 6.71A
13. Ipk(Secondary) | 4.32A
14. Irms(Secondary) | 1.74A

## Design Assistance

1. Master key : C0D589C8A459FFAEFA08F6C55363D542[v1]
2. UC3843A Product Folder : http://www.ti.com/product/UC3843A : contains the data sheet and other resources.

Important Notice and Disclaimer

TI provides technical and reliability data (including datasheets), design resources (including reference designs), application or other design advice, web tools, safety information, and other resources AS IS and with all faults, and disclaims all warranties. These resources are intended for skilled developers designing with TI products. You are solely responsible for (1) selecting the appropriate TI products for your application, (2) designing, validating and testing your application, and (3) ensuring your application meets applicable standards, and any other safety, security, or other requirements.

These resources are subject to change without notice. TI grants you permission to use these resources only for development of an application that uses the TI products described in the resource. Other reproduction and display of these resources is prohibited. No license is granted to any other TI intellectual property right or to any third party intellectual property right. TI disclaims responsibility for, and you will fully indemnify TI and its representatives against, any claims, damages, costs, losses, and liabilities arising out of your use of these resources.

Providing these resources does not expand or otherwise alter TI's applicable Terms of Sale or other applicable terms available either on ti.com or provided in conjunction with TI products.
