ozanakturk/Dragonfly/ltspice/utku/erroramp.asc

ErrorAmp: UniversalOpAmp
R2: res; 4.99k
R3: res; 12.7k
Rcomp: res; 10k
V1: voltage; 5
V2: voltage; -5
V3: voltage; 2.5
V4: voltage; 4.8
Named nets: 0, V+, V-, Vnon, Vref, Vout, FB, COMP
.dc V4 0 10
