ozanakturk/Dragonfly/(commit log)

2023-04-22 Magnetic Design started
2023-04-27 magnetic design script added
2023-05-04 Update of Magnetic Design
2023-05-05 magnetic design calculations
2023-05-05 Magnetic design calculation is editted
2023-05-09 Switching losses link added
